adlerweb/iSysBus/misc/appnotes/README.txt

These files where removed from the original repository due to copyright concerns.

https://www.nxp.com/docs/en/application-note/AN96116.pdf
https://www.microchip.com/wwwAppNotes/AppNotes.aspx?appnote=en590906
https://www.microchip.com/wwwAppNotes/AppNotes.aspx?appnote=en591393
http://ww1.microchip.com/downloads/en/appnotes/doc2563.pdf
AVR055: Using a 32 kHz crystal to calibrate the internal RC oscillator
http://ww1.microchip.com/downloads/en/AppNotes/Atmel-2508-Zero-Cross-Detector_ApplicationNote_AVR182.pdf
https://www.microchip.com/wwwappnotes/appnotes.aspx?appnote=en591191
http://ww1.microchip.com/downloads/en/appnotes/atmel-2559-characterization-and-calibration-of-the-adc-on-an-avr_applicationnote_avr120.pdf
https://www.microchip.com/wwwAppNotes/AppNotes.aspx?appnote=en591540
http://ww1.microchip.com/downloads/en/AppNotes/Atmel-8108-Calibration-of-the-AVRs-Internal-Temperature-Reference_ApplicationNote_AVR122.pdf
AVR411
AVR415
AVR151
AVR303
AVR319
AVR320
AVR311
AVR315
AVR460
AVR461
Avr462
