adlerweb/iSysBus/misc/datasheets/mechanical/RJ45-Connector.pdf.txt

DELETED. Please search online for RJ45-Connector.pdf
