adlerweb/iSysBus/misc/datasheets/mechanical/USB-B-Connector.pdf.txt

DELETED. Please search online for USB-B-Connector.pdf
