adlerweb/iSysBus/misc/funk_steckdosen/radio_protocol.txt

   1011001011011011001011001001011001011011011001011011011001 Früher button 1 ein
1001011001011011011001011001001011001011011011001011011011001 gerade gescannt
01011101001011101110

1001011001011011011001011001001011001001011011001011011001001 Button 2 ein
--------------------------------------D-----------------D---- Differenz

1001011001011011011001011001001011001011001011001011011011011 Button 3 ein
-----------------------------------------D-----------------D- Diffenenz zu button 1
01011101001010101111

1001011001011011011001011001001011001001001011001011011001011 Button 4 ein
--------------------------------------D--D--------------D--D- 
01011101001000101101

1001011001011011011001011001001011001011011011011011011011    Button 1 AUs
1001011001011011011001011001001011001011011011011011011011011
-----------------------------------------------D--------D--D- Differnez zu button 1

1001011001011011011001011001001011001001011011011011011001011 Button 2 Aus
-----------------------------------------------D-----------D-

1001011001011011011001011001001011001011001011011011011011001 Button 3 Aus
-----------------------------------------------D-----------D-

1001011001011011011001011001001011001011001011011001011001001 Heller
--------------------------------------------------D-----D--D-

Anderer Code:
1001001001001001011011001001011001001011011011001011011011 (0)
1001001001001001011011001001011001001011011011001011011011001 Button 1 Neuer Code
-----D-----D--D-----D--D-----D--D---------------------------- Differenz zu Altem Button 1
--c--c--c--c--c--c--c--c--c--c--c--c--c--c--c--c--c--c--c--c-

Nochmal neuer Code
1011001001001001011011011001001001001011011011001011011011001 Button 1 Neuer Code
--D--D-----D--D-----D-----------D---------------------------- Differenz zu ganz altem code
10 00 01 11 00 00 11 10 11 10

1011001001001001011011011001001001001001001001001011011011011 Alle ein
--D--D-----D--D-----D-----------D-----D--D--D--------------D- Diff zu button1 Ein
10 00 01 11 00 00 00 00 11 11

1011001001001001011011011001001001001001001001001001011001011 Dimmen
--------------------------------------------------D-----D---- Diff zu alle ein

--c--c--c--c--c--c--c--c--c--c--c--c--c--c--c--c--c--c--c--c- c für variabel
10x10x10x10x10x10x10x10x10x10x10x10x10x10x10x10x10x10x10x10x1 Aufbau der Daten, x für Variables bit
                                      1  1		      Button 1
                                      0  1                    Button 2
                                      1  0                    Button 3  
                                      0  0                    Button 4
                                               1              Ausschalte ( Null einschalten)
---------------------------------  ?			      Fernbedienungs code
                                                        ?  ?  Kontroll bit??
                                                  ?  ?        Heller Dunkler ??
                                            0                 Alle 

bei 1450 Baud 
Tipp zum Auslesen: nur nach doppel 1 und doppel 0 suchen  11=1, doppel 00 = 0

Daten:
01 01 11 01 00 10 11 10 11 10 bu1
01 01 11 01 00 10 10 10 11 11 bu3
01 01 11 01 00 10 00 10 11 01 bu4
10 00 01 11 00 00 00 00 11 11 Alle ein andere code
10 00 01 11 00 00 11 10 11 10 button 1 neuer code

xor
01 00 11 10 10 00 11 01 10
01 00 11 10 10 00 10 00 11
01 00 11 10 10 00 00 00 11  ! passt noch net ?? Ausnahme
10 10 11 00 00 00 00 00 11
10 10 11 00 00 00 11 01 10
