adlerweb/iSysBus/misc/funk_steckdosen/protocol.jpg

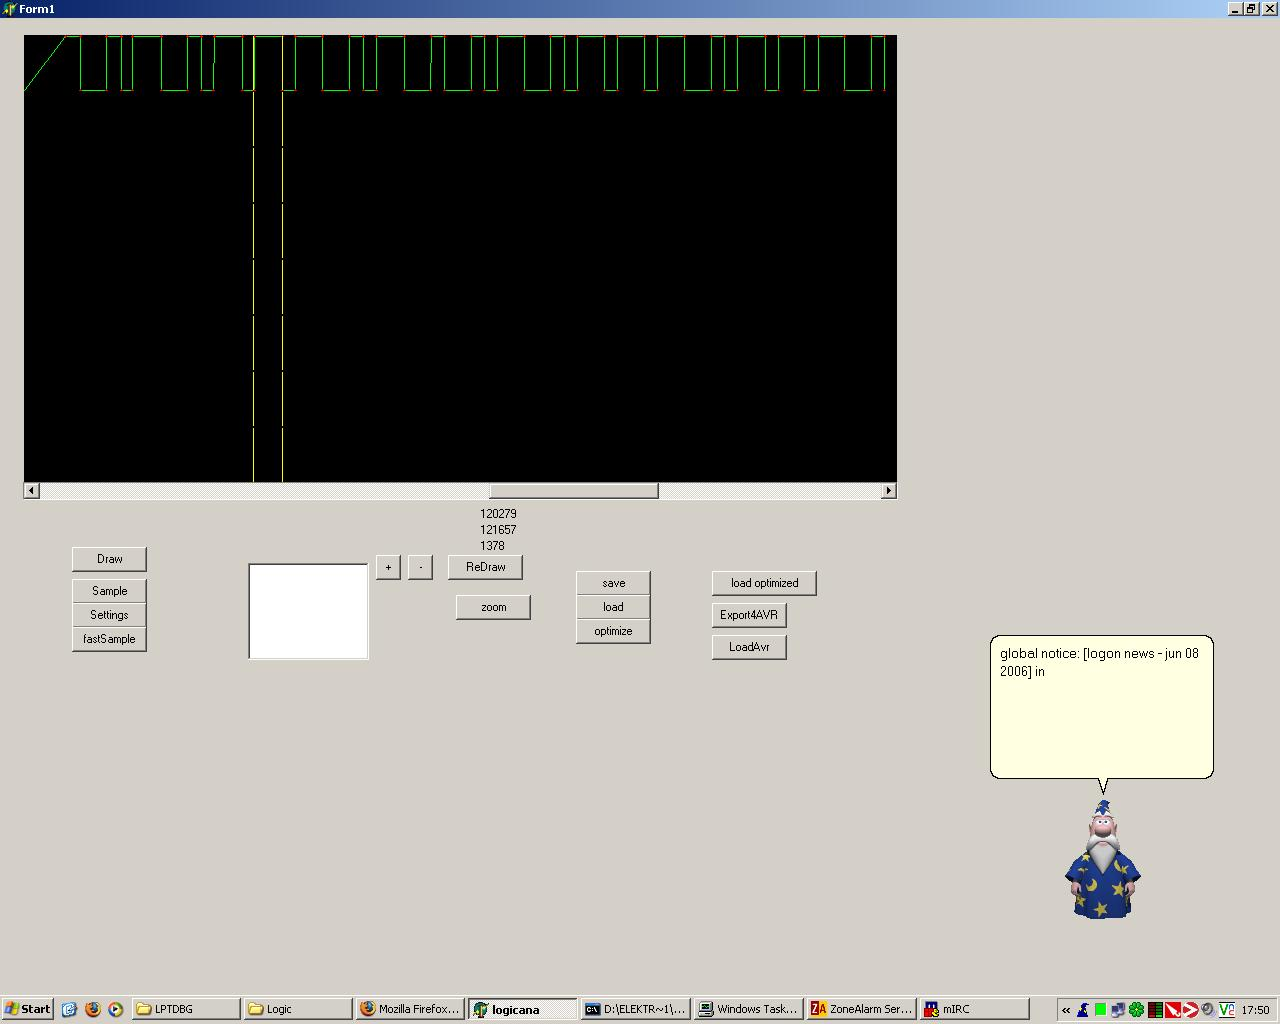
misc/funk_steckdosen/protocol.jpg
