adlerweb/iSysBus/software/sniffer/release/0.8.35/screenshot.png

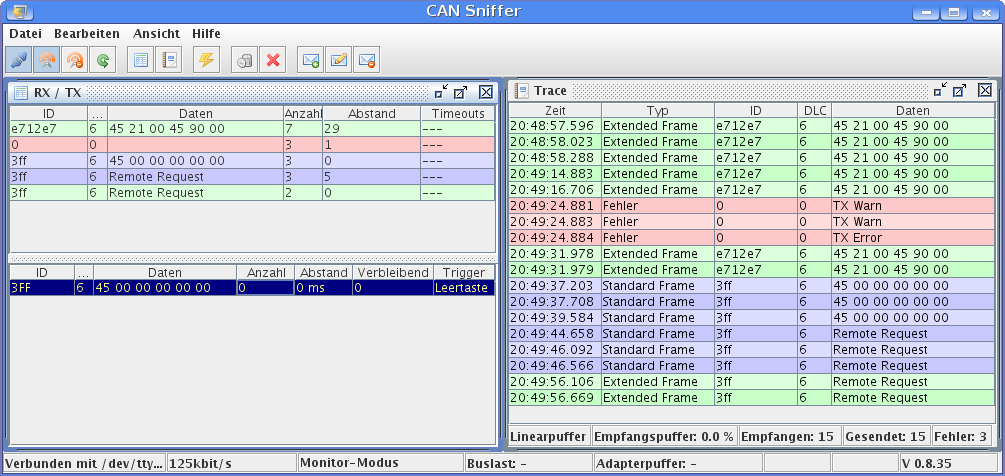
software/sniffer/release/0.8.35/screenshot.png
