adlerweb/iSysBus/misc/datasheets/supply/LM2574_StepDown-VoltageRegulator.pdf.txt

DELETED. Please search online for LM2574_StepDown-VoltageRegulator.pdf
