adlerweb/iSysBus/misc/datasheets/microcontrollers/AVR_Instruction_Set.pdf.txt

DELETED. Please search online for AVR_Instruction_Set.pdf
