adlerweb/iSysBus/misc/datasheets/misc/TS912_STM_Operational_Amplifier_2-fach.pdf.txt

DELETED. Please search online for TS912_STM_Operational_Amplifier_2-fach.pdf
