adlerweb/iSysBus/misc/docs/can_measured-timings/bits.ods

 |  |  |  |  |  |  |  |  |  |  |  |  | SOF | ID[10..0] |  |  |  |  |  |  |  |  |  |  | SRR | IDE | EID[17..0] |  |  |  |  |  |  |  |  |  |  |  |  |  |  |  |  |  | RTR | RB |  | DLC[3..0] |  |  |  | DATA0[7..0]
 |  |  |  |  |  |  |  |  |  |  |  |  |  | 10 | 9 | 8 | 7 | 6 | 5 | 4 | 3 | 2 | 1 | 0 |  |  | 17 | 16 | 15 | 14 | 13 | 12 | 11 | 10 | 9 | 8 | 7 | 6 | 5 | 4 | 3 | 2 | 1 | 0 |  | 1 | 0 | 3 | 2 | 1 | 0 | 7 | 6 | 5 | 4 | 3 | 2 | 1 | 0
 |  |  |  |  |  |  |  |  |  |  | d | d | d | d | d | r | r | r | d | d | d | d | d | r | r | r | d | r | r | r | r | d | r | r | r | r | r | d | r | r | r | d | d | r | d | d | d | d | d | r | d | r | d | d | r | r | r | d | r
0 | 0 | 0 | 0 | 0 | 0 | 0 | 0 | 0 | 0 | 0 | 0 | 0 | 0 | 0 | 0 | 1 | 1 | 1 | 0 | 0 | 0 | 0 | 0 | 1 | 1 | 1 | 0 | 1 | 1 | 1 | 1 | 0 | 1 | 1 | 1 | 1 | 1 | 0 | 1 | 1 | 1 | 0 | 0 | 1 | 0 | 0 | 0 | 0 | 0 | 1 | 0 | 1 | 0 | 0 | 1 | 1 | 1 | 0 | 1
 |  |  |  |  |  |  |  |  |  |  |  |  |  |  |  |  |  |  |  |  |  |  |  |  |  |  |  |  |  |  |  |  |  |  |  |  |  |  |  |  |  |  |  |  |  |  |  | 2 |  |  |  | 0x9D
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
