adlerweb/iSysBus/misc/docs/can_measured-timings/50kBaud_RS8k.tif

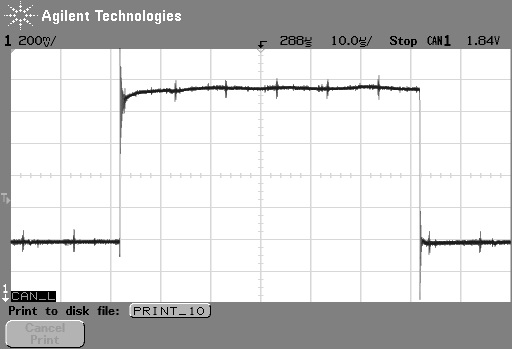
misc/docs/can_measured-timings/50kBaud_RS8k.tif
