adlerweb/iSysBus/misc/docs/can_measured-timings/50kBaud_RS47k.tif

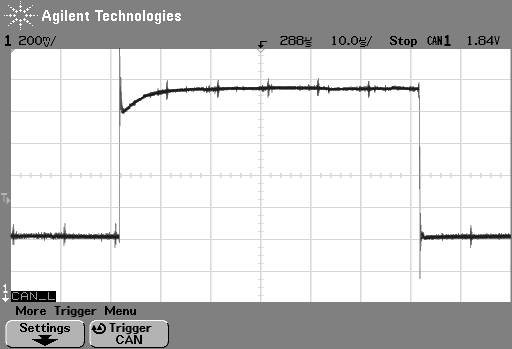
misc/docs/can_measured-timings/50kBaud_RS47k.tif
