adlerweb/iSysBus/misc/docs/can_measured-timings/50kBaud_RS47k_Varistor12nF.tif

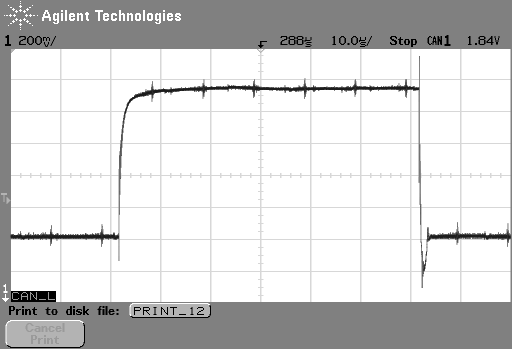
misc/docs/can_measured-timings/50kBaud_RS47k_Varistor12nF.tif
