adlerweb/iSysBus/misc/docs/can_measured-timings/125kBaud_RS47k_2.tif

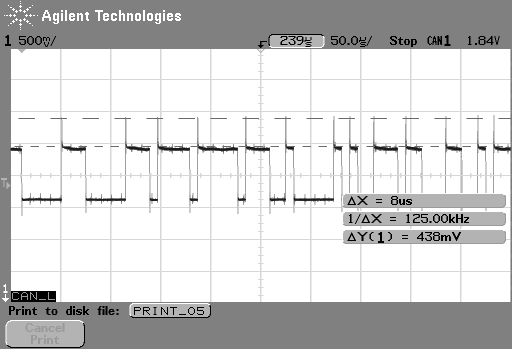
misc/docs/can_measured-timings/125kBaud_RS47k_2.tif
