adlerweb/iSysBus/misc/datasheets/interfacecontrollers/ENC28J60-Errata.pdf.txt

DELETED. Please search online for ENC28J60-Errata.pdf
