adlerweb/iSysBus/devices/circuit_boards/pcb_2_in_wall_input/trunk/pcb_2.brd

## EAGLE design devices/circuit_boards/pcb_2_in_wall_input/trunk/pcb_2.brd (2018-11-25)

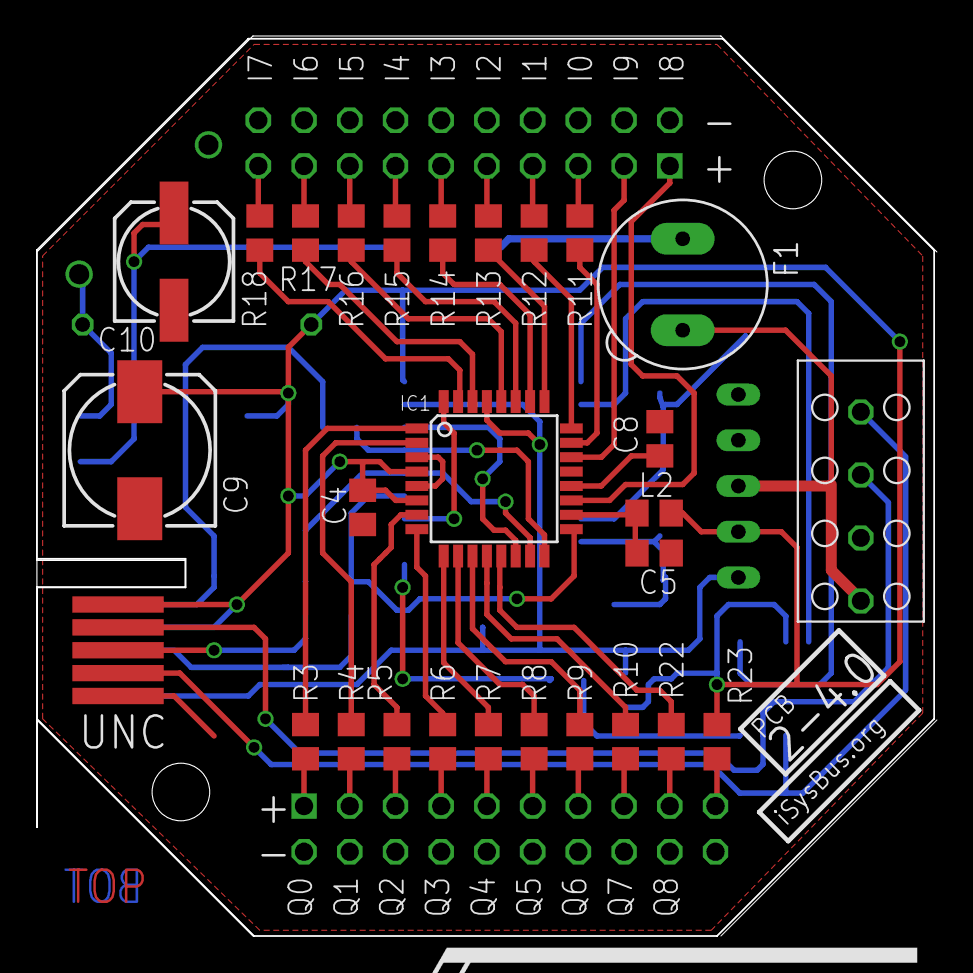
[picture p12: board pcb_2.brd from above]

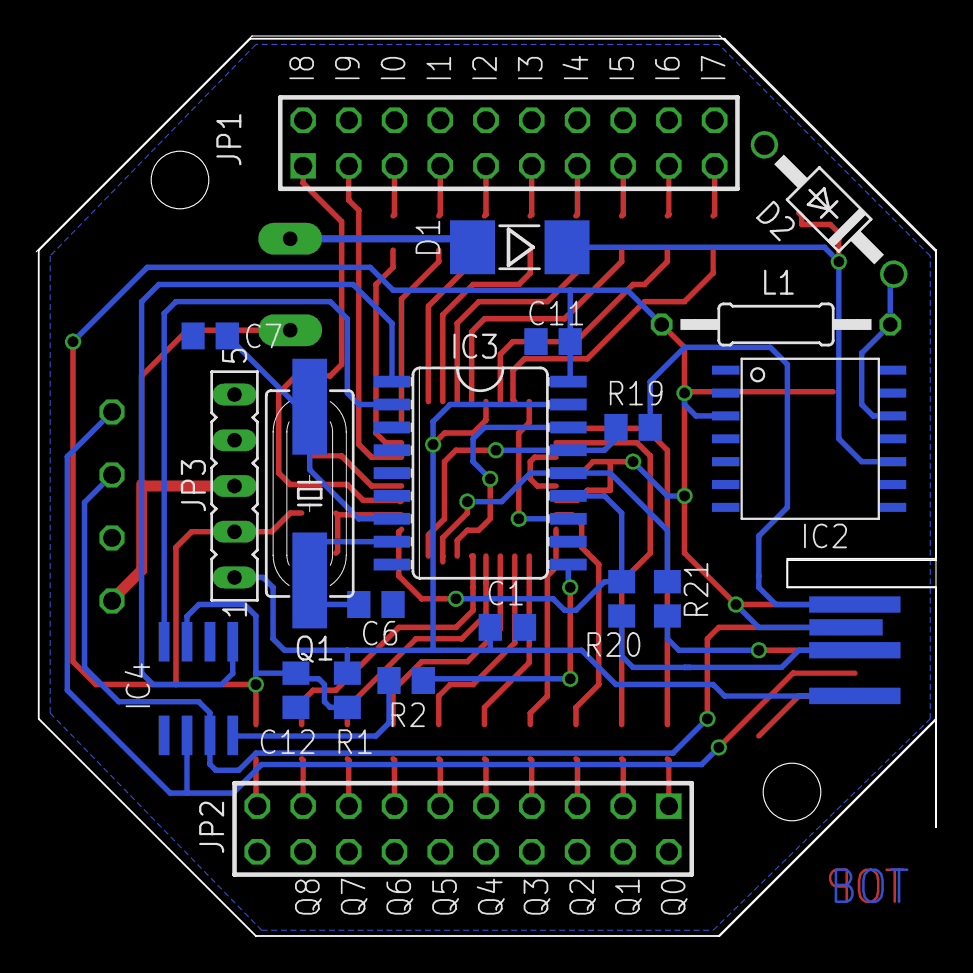
[picture p13: board pcb_2.brd from below]

Board: 2 copper layers, 49.8 x 49.8 mm, 54 parts (20 on the bottom side), 62 nets.

Parts:
C1, C4, C5, C8, C11, C12: 100n; C0805
C6, C7: 22p; C0805
C9: 330µ/16V; 153CLV-0810
C10: 22µ/35V; 153CLV-0605
D1: 1N4001SMD; MELF
D2: MUR110; DO41-10
F1: 315mA; 19560
IC1: ATMEGA168; TQFP32-08
IC2: LM257414WM; 14WM
IC3: MCP2515SO; SO18L
IC4: PCA82C250T; SO08
JP1: IN; 2X10
JP2: OUT; 2X10
JP3: SUP; FE05-1
L1: 470µ; 0207/12
L2: 10µ; L0805
Q1: 4M; HC49UP
R1: 10k; R0805
R2: 82k; R0805
R3, R4, R5, R6, R7, R8, R9, R10, R11, R12, R13, R14, R15, R16, R17, R18, R19, R20, R21, R22: 1k5; R0805
R23: 0R; R0805
U$1: ISYSBUS_LOGO
U$2: FIELD_ISB_PLACE
U$3: 2-4.0; FIELD_PCB_PLACE
UNC: UNC_ISP; UNC_PADS_ISP
UNC_CAN1: UNC_CAN; UNC_PADS_CAN
UNC_DP1: UNC_DP; UNC_PADS_DP
UNC_SUPPLY1: UNC_SUPPLY; UNC_PADS_SUPPLY
X1: iSysBus; PHOENIX_FK-MPT_4

Connections:
+24V: F1.2, JP3.3, X1.1
CAN_H: IC4.7, UNC_CAN1.B2, X1.3
CAN_L: IC4.6, UNC_CAN1.B4, X1.4
GND: C1.2, C4.2, C5.2, C6.2, C7.2, C8.2, C9.-, C10.-, C11.2, C12.2, D2.A, IC1.3, IC1.5, IC1.21, IC2.4, IC2.5, IC2.6, IC3.9, IC4.2, JP1.2, JP1.4, JP1.6, JP1.8, JP1.10, JP1.12, JP1.14, JP1.16, JP1.18, JP1.20, JP2.2, JP2.4, JP2.6, JP2.8, JP2.10, JP2.12, JP2.14, JP2.16, JP2.18, JP2.20, JP3.5, UNC_SUPPLY1.B5, X1.2
IN0: IC1.23, R11.1
IN1: IC1.24, R12.1
IN2: IC1.25, R13.1
IN3: IC1.26, R14.1
IN4: IC1.27, R15.1
IN5: IC1.28, R16.1
IN6: IC1.30, R17.1
IN7: IC1.31, R18.1
IN8: IC1.19, JP1.1
IN9: IC1.22, JP1.3
INT: IC1.32, IC3.12
MISO: IC1.16, IC3.15, R19.1
MOSI: IC1.15, IC3.14, R21.1
unnamed: D1.A, F1.1
unnamed: C5.1, IC1.18, L2.2
unnamed: D2.C, IC2.12, L1.2
unnamed: IC4.8, R2.2
unnamed: C6.1, IC3.8, Q1.1
unnamed: C8.1, IC1.20
unnamed: IC3.1, IC4.1
unnamed: IC3.2, IC4.4
unnamed: C7.1, IC3.7, Q1.2
unnamed: JP2.19, R23.2
unnamed: JP2.1, R3.2
unnamed: JP2.3, R4.2
unnamed: JP2.5, R5.2
unnamed: JP2.7, R6.2
unnamed: JP2.9, R7.2
unnamed: JP2.11, R8.2
unnamed: JP2.13, R9.2
unnamed: JP2.15, R10.2
unnamed: JP1.19, R18.2
unnamed: JP1.17, R17.2
unnamed: JP1.15, R16.2
unnamed: JP1.13, R15.2
unnamed: JP1.11, R14.2
unnamed: JP1.9, R13.2
unnamed: JP1.7, R12.2
unnamed: JP1.5, R11.2
unnamed: R20.2, UNC.A3
unnamed: R19.2, UNC.A1
unnamed: R21.2, UNC.B3
unnamed: JP2.17, R22.2
OUT0: IC1.1, R3.1
OUT1: IC1.2, R4.1
OUT2: IC1.7, R5.1
OUT3: IC1.8, R6.1
OUT4: IC1.9, R7.1
OUT5: IC1.10, R8.1
OUT6: IC1.11, R9.1
OUT7: IC1.12, R10.1
OUT8: IC1.13, R22.1
RESET: C1.1, IC1.29, IC3.17, JP3.1, R1.1, UNC.A5
RS: IC3.10, R2.1
SCK: IC1.17, IC3.13, R20.1
SS: IC1.14, IC3.16
V+: C10.+, D1.C, IC2.10
VCC: C4.1, C9.+, C11.1, C12.1, IC1.4, IC1.6, IC2.3, IC3.18, IC4.3, JP3.2, L1.1, L2.1, R1.2, R23.1, UNC_DP1.A2, UNC_SUPPLY1.B1
