adlerweb/iSysBus/firmware/fw/fw_27/trunk/main.c

/**
 * @file		fw/fw_27/trunk/main.c
 *
 * @brief		Firmware.
 *
 * This file includes the Firmware.
 *
 * @author		© Patrick Amrhein <trick-at-isysbus-dot-org> 01.05.2010.
 *
 * @date		$Date$
 *
 * @version		$Rev$
 *
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
 * You should have received a copy of the GNU General Public License
 * along with this program. If not, see http:*www.gnu.org/licenses.
 */





#include <stdio.h>



#define USE_AVRLIB_ISB



#include <trunk/core/isb_fw_app.h>



const uint8_t Isb_Firmware_Code[4] = { 0x1B, 0x00, 0x00, 0x00 };



#define ISB_INF_CAN0 TRUE
#if ISB_INF_CAN0 == TRUE
	#define ISB_INF_CAN0_CLOCK 8000000
	#define ISB_INF_CAN0_SPEED 50000
	#define ISB_INF_CAN0_SS PORTB_PIN4
	#define ISB_INF_CAN0_RS NONE
	#define ISB_INF_CAN0_INT INTERRUPT1
	#define ISB_INF_CAN0_MODE LIB_MCP2515_MODE_NORMAL
#endif /* ISB_INF_CAN0 == TRUE */



#define ISB_CH_MAX 8

#define ISB_CH_0 0
#if defined(ISB_CH_0)
	#define ISB_CH_0_EEADDR_CTRL 0x0000
	#define ISB_APP_DIGOUT_0 0
	#define ISB_APP_DIGOUT_0_CH 0
	#define ISB_APP_DIGOUT_0_PIN0 B | 0
	#define ISB_APP_DIGOUT_0_PIN1 A | 0 | PULLUP
	#define ISB_APP_DIGOUT_0_EEADDR_CFG0 0x0001
	#define ISB_APP_DIGOUT_0_OBJ_0_EEADDR_CTRL 0x0002
	#define ISB_APP_DIGOUT_0_OBJ_0_EEADDR_TOV 0x0003
	#define ISB_APP_DIGOUT_0_OBJ_0_EEADDR_INITVALUE 0x0004
	#define ISB_APP_DIGOUT_0_OBJ_0 0
	#define ISB_OBJ_0 0
	#define ISB_OBJ_0_CH 0
	#define ISB_APP_DIGOUT_0_EEADDR_CFG1 0x0009
	#define ISB_APP_DIGOUT_0_OBJ_1_EEADDR_CTRL 0x000A
	#define ISB_APP_DIGOUT_0_OBJ_1_EEADDR_TOV 0x000B
	#define ISB_APP_DIGOUT_0_OBJ_1_EEADDR_INITVALUE 0x000C
	#define ISB_APP_DIGOUT_0_OBJ_1 1
	#define ISB_OBJ_1 1
	#define ISB_OBJ_1_CH 0
	#define ISB_APP_DIGOUT_0_EEADDR_CFG2 0x0011
	#define ISB_APP_DIGOUT_0_OBJ_2_EEADDR_CTRL 0x0012
	#define ISB_APP_DIGOUT_0_OBJ_2_EEADDR_TOV 0x0013
	#define ISB_APP_DIGOUT_0_OBJ_2_EEADDR_INITVALUE 0x0014
	#define ISB_APP_DIGOUT_0_OBJ_2 2
	#define ISB_OBJ_2 2
	#define ISB_OBJ_2_CH 0
	#define ISB_APP_DIGOUT_0_EEADDR_CFG3 0x0019
	#define ISB_APP_DIGOUT_0_EEADDR_CFG4 0x001A
	#define ISB_APP_DIGOUT_0_EEADDR_CFG5 0x001B
	#define ISB_APP_DIGOUT_0_EEADDR_CFG6 0x001C
	#define ISB_APP_DIGOUT_0_EEADDR_CFG7 0x001D
	#define ISB_APP_DIGOUT_0_EEADDR_CFG8 0x001E
	#define ISB_APP_DIGOUT_0_EEADDR_CFG9 0x001F
	#define ISB_APP_DIGOUT_0_EEADDR_CFG10 0x0020
	#define ISB_APP_DIGOUT_0_OBJ_3_EEADDR_CTRL 0x0021
	#define ISB_APP_DIGOUT_0_OBJ_3_EEADDR_TOV 0x0022
	#define ISB_APP_DIGOUT_0_OBJ_3_EEADDR_INITVALUE 0x0023
	#define ISB_APP_DIGOUT_0_OBJ_3 3
	#define ISB_OBJ_3 3
	#define ISB_OBJ_3_CH 0
	#define ISB_CH_0_EEADDR_CRC 0x0028
#endif /* ISB_CH_0 */

#define ISB_CH_1 1
#if defined(ISB_CH_1)
	#define ISB_CH_1_EEADDR_CTRL 0x0029
	#define ISB_APP_DIGOUT_1 1
	#define ISB_APP_DIGOUT_1_CH 1
	#define ISB_APP_DIGOUT_1_PIN0 B | 1
	#define ISB_APP_DIGOUT_1_PIN1 A | 1 | PULLUP
	#define ISB_APP_DIGOUT_1_EEADDR_CFG0 0x002A
	#define ISB_APP_DIGOUT_1_OBJ_0_EEADDR_CTRL 0x002B
	#define ISB_APP_DIGOUT_1_OBJ_0_EEADDR_TOV 0x002C
	#define ISB_APP_DIGOUT_1_OBJ_0_EEADDR_INITVALUE 0x002D
	#define ISB_APP_DIGOUT_1_OBJ_0 4
	#define ISB_OBJ_4 4
	#define ISB_OBJ_4_CH 1
	#define ISB_APP_DIGOUT_1_EEADDR_CFG1 0x0032
	#define ISB_APP_DIGOUT_1_OBJ_1_EEADDR_CTRL 0x0033
	#define ISB_APP_DIGOUT_1_OBJ_1_EEADDR_TOV 0x0034
	#define ISB_APP_DIGOUT_1_OBJ_1_EEADDR_INITVALUE 0x0035
	#define ISB_APP_DIGOUT_1_OBJ_1 5
	#define ISB_OBJ_5 5
	#define ISB_OBJ_5_CH 1
	#define ISB_APP_DIGOUT_1_EEADDR_CFG2 0x003A
	#define ISB_APP_DIGOUT_1_OBJ_2_EEADDR_CTRL 0x003B
	#define ISB_APP_DIGOUT_1_OBJ_2_EEADDR_TOV 0x003C
	#define ISB_APP_DIGOUT_1_OBJ_2_EEADDR_INITVALUE 0x003D
	#define ISB_APP_DIGOUT_1_OBJ_2 6
	#define ISB_OBJ_6 6
	#define ISB_OBJ_6_CH 1
	#define ISB_APP_DIGOUT_1_EEADDR_CFG3 0x0042
	#define ISB_APP_DIGOUT_1_EEADDR_CFG4 0x0043
	#define ISB_APP_DIGOUT_1_EEADDR_CFG5 0x0044
	#define ISB_APP_DIGOUT_1_EEADDR_CFG6 0x0045
	#define ISB_APP_DIGOUT_1_EEADDR_CFG7 0x0046
	#define ISB_APP_DIGOUT_1_EEADDR_CFG8 0x0047
	#define ISB_APP_DIGOUT_1_EEADDR_CFG9 0x0048
	#define ISB_APP_DIGOUT_1_EEADDR_CFG10 0x0049
	#define ISB_APP_DIGOUT_1_OBJ_3_EEADDR_CTRL 0x004A
	#define ISB_APP_DIGOUT_1_OBJ_3_EEADDR_TOV 0x004B
	#define ISB_APP_DIGOUT_1_OBJ_3_EEADDR_INITVALUE 0x004C
	#define ISB_APP_DIGOUT_1_OBJ_3 7
	#define ISB_OBJ_7 7
	#define ISB_OBJ_7_CH 1
	#define ISB_CH_1_EEADDR_CRC 0x0051
#endif /* ISB_CH_1 */

#define ISB_CH_2 2
#if defined(ISB_CH_2)
	#define ISB_CH_2_EEADDR_CTRL 0x0052
	#define ISB_APP_DIGOUT_2 2
	#define ISB_APP_DIGOUT_2_CH 2
	#define ISB_APP_DIGOUT_2_PIN0 C | 2
	#define ISB_APP_DIGOUT_2_PIN1 A | 2 | PULLUP
	#define ISB_APP_DIGOUT_2_EEADDR_CFG0 0x0053
	#define ISB_APP_DIGOUT_2_OBJ_0_EEADDR_CTRL 0x0054
	#define ISB_APP_DIGOUT_2_OBJ_0_EEADDR_TOV 0x0055
	#define ISB_APP_DIGOUT_2_OBJ_0_EEADDR_INITVALUE 0x0056
	#define ISB_APP_DIGOUT_2_OBJ_0 8
	#define ISB_OBJ_8 8
	#define ISB_OBJ_8_CH 2
	#define ISB_APP_DIGOUT_2_EEADDR_CFG1 0x005B
	#define ISB_APP_DIGOUT_2_OBJ_1_EEADDR_CTRL 0x005C
	#define ISB_APP_DIGOUT_2_OBJ_1_EEADDR_TOV 0x005D
	#define ISB_APP_DIGOUT_2_OBJ_1_EEADDR_INITVALUE 0x005E
	#define ISB_APP_DIGOUT_2_OBJ_1 9
	#define ISB_OBJ_9 9
	#define ISB_OBJ_9_CH 2
	#define ISB_APP_DIGOUT_2_EEADDR_CFG2 0x0063
	#define ISB_APP_DIGOUT_2_OBJ_2_EEADDR_CTRL 0x0064
	#define ISB_APP_DIGOUT_2_OBJ_2_EEADDR_TOV 0x0065
	#define ISB_APP_DIGOUT_2_OBJ_2_EEADDR_INITVALUE 0x0066
	#define ISB_APP_DIGOUT_2_OBJ_2 10
	#define ISB_OBJ_10 10
	#define ISB_OBJ_10_CH 2
	#define ISB_APP_DIGOUT_2_EEADDR_CFG3 0x006B
	#define ISB_APP_DIGOUT_2_EEADDR_CFG4 0x006C
	#define ISB_APP_DIGOUT_2_EEADDR_CFG5 0x006D
	#define ISB_APP_DIGOUT_2_EEADDR_CFG6 0x006E
	#define ISB_APP_DIGOUT_2_EEADDR_CFG7 0x006F
	#define ISB_APP_DIGOUT_2_EEADDR_CFG8 0x0070
	#define ISB_APP_DIGOUT_2_EEADDR_CFG9 0x0071
	#define ISB_APP_DIGOUT_2_EEADDR_CFG10 0x0072
	#define ISB_APP_DIGOUT_2_OBJ_3_EEADDR_CTRL 0x0073
	#define ISB_APP_DIGOUT_2_OBJ_3_EEADDR_TOV 0x0074
	#define ISB_APP_DIGOUT_2_OBJ_3_EEADDR_INITVALUE 0x0075
	#define ISB_APP_DIGOUT_2_OBJ_3 11
	#define ISB_OBJ_11 11
	#define ISB_OBJ_11_CH 2
	#define ISB_CH_2_EEADDR_CRC 0x007A
#endif /* ISB_CH_2 */

#define ISB_CH_3 3
#if defined(ISB_CH_3)
	#define ISB_CH_3_EEADDR_CTRL 0x007B
	#define ISB_APP_DIGOUT_3 3
	#define ISB_APP_DIGOUT_3_CH 3
	#define ISB_APP_DIGOUT_3_PIN0 C | 3
	#define ISB_APP_DIGOUT_3_PIN1 A | 3 | PULLUP
	#define ISB_APP_DIGOUT_3_EEADDR_CFG0 0x007C
	#define ISB_APP_DIGOUT_3_OBJ_0_EEADDR_CTRL 0x007D
	#define ISB_APP_DIGOUT_3_OBJ_0_EEADDR_TOV 0x007E
	#define ISB_APP_DIGOUT_3_OBJ_0_EEADDR_INITVALUE 0x007F
	#define ISB_APP_DIGOUT_3_OBJ_0 12
	#define ISB_OBJ_12 12
	#define ISB_OBJ_12_CH 3
	#define ISB_APP_DIGOUT_3_EEADDR_CFG1 0x0084
	#define ISB_APP_DIGOUT_3_OBJ_1_EEADDR_CTRL 0x0085
	#define ISB_APP_DIGOUT_3_OBJ_1_EEADDR_TOV 0x0086
	#define ISB_APP_DIGOUT_3_OBJ_1_EEADDR_INITVALUE 0x0087
	#define ISB_APP_DIGOUT_3_OBJ_1 13
	#define ISB_OBJ_13 13
	#define ISB_OBJ_13_CH 3
	#define ISB_APP_DIGOUT_3_EEADDR_CFG2 0x008C
	#define ISB_APP_DIGOUT_3_OBJ_2_EEADDR_CTRL 0x008D
	#define ISB_APP_DIGOUT_3_OBJ_2_EEADDR_TOV 0x008E
	#define ISB_APP_DIGOUT_3_OBJ_2_EEADDR_INITVALUE 0x008F
	#define ISB_APP_DIGOUT_3_OBJ_2 14
	#define ISB_OBJ_14 14
	#define ISB_OBJ_14_CH 3
	#define ISB_APP_DIGOUT_3_EEADDR_CFG3 0x0094
	#define ISB_APP_DIGOUT_3_EEADDR_CFG4 0x0095
	#define ISB_APP_DIGOUT_3_EEADDR_CFG5 0x0096
	#define ISB_APP_DIGOUT_3_EEADDR_CFG6 0x0097
	#define ISB_APP_DIGOUT_3_EEADDR_CFG7 0x0098
	#define ISB_APP_DIGOUT_3_EEADDR_CFG8 0x0099
	#define ISB_APP_DIGOUT_3_EEADDR_CFG9 0x009A
	#define ISB_APP_DIGOUT_3_EEADDR_CFG10 0x009B
	#define ISB_APP_DIGOUT_3_OBJ_3_EEADDR_CTRL 0x009C
	#define ISB_APP_DIGOUT_3_OBJ_3_EEADDR_TOV 0x009D
	#define ISB_APP_DIGOUT_3_OBJ_3_EEADDR_INITVALUE 0x009E
	#define ISB_APP_DIGOUT_3_OBJ_3 15
	#define ISB_OBJ_15 15
	#define ISB_OBJ_15_CH 3
	#define ISB_CH_3_EEADDR_CRC 0x00A3
#endif /* ISB_CH_3 */

#define ISB_CH_4 4
#if defined(ISB_CH_4)
	#define ISB_CH_4_EEADDR_CTRL 0x00A4
	#define ISB_APP_DIGOUT_4 4
	#define ISB_APP_DIGOUT_4_CH 4
	#define ISB_APP_DIGOUT_4_PIN0 C | 4
	#define ISB_APP_DIGOUT_4_PIN1 A | 4 | PULLUP
	#define ISB_APP_DIGOUT_4_EEADDR_CFG0 0x00A5
	#define ISB_APP_DIGOUT_4_OBJ_0_EEADDR_CTRL 0x00A6
	#define ISB_APP_DIGOUT_4_OBJ_0_EEADDR_TOV 0x00A7
	#define ISB_APP_DIGOUT_4_OBJ_0_EEADDR_INITVALUE 0x00A8
	#define ISB_APP_DIGOUT_4_OBJ_0 16
	#define ISB_OBJ_16 16
	#define ISB_OBJ_16_CH 4
	#define ISB_APP_DIGOUT_4_EEADDR_CFG1 0x00AD
	#define ISB_APP_DIGOUT_4_OBJ_1_EEADDR_CTRL 0x00AE
	#define ISB_APP_DIGOUT_4_OBJ_1_EEADDR_TOV 0x00AF
	#define ISB_APP_DIGOUT_4_OBJ_1_EEADDR_INITVALUE 0x00B0
	#define ISB_APP_DIGOUT_4_OBJ_1 17
	#define ISB_OBJ_17 17
	#define ISB_OBJ_17_CH 4
	#define ISB_APP_DIGOUT_4_EEADDR_CFG2 0x00B5
	#define ISB_APP_DIGOUT_4_OBJ_2_EEADDR_CTRL 0x00B6
	#define ISB_APP_DIGOUT_4_OBJ_2_EEADDR_TOV 0x00B7
	#define ISB_APP_DIGOUT_4_OBJ_2_EEADDR_INITVALUE 0x00B8
	#define ISB_APP_DIGOUT_4_OBJ_2 18
	#define ISB_OBJ_18 18
	#define ISB_OBJ_18_CH 4
	#define ISB_APP_DIGOUT_4_EEADDR_CFG3 0x00BD
	#define ISB_APP_DIGOUT_4_EEADDR_CFG4 0x00BE
	#define ISB_APP_DIGOUT_4_EEADDR_CFG5 0x00BF
	#define ISB_APP_DIGOUT_4_EEADDR_CFG6 0x00C0
	#define ISB_APP_DIGOUT_4_EEADDR_CFG7 0x00C1
	#define ISB_APP_DIGOUT_4_EEADDR_CFG8 0x00C2
	#define ISB_APP_DIGOUT_4_EEADDR_CFG9 0x00C3
	#define ISB_APP_DIGOUT_4_EEADDR_CFG10 0x00C4
	#define ISB_APP_DIGOUT_4_OBJ_3_EEADDR_CTRL 0x00C5
	#define ISB_APP_DIGOUT_4_OBJ_3_EEADDR_TOV 0x00C6
	#define ISB_APP_DIGOUT_4_OBJ_3_EEADDR_INITVALUE 0x00C7
	#define ISB_APP_DIGOUT_4_OBJ_3 19
	#define ISB_OBJ_19 19
	#define ISB_OBJ_19_CH 4
	#define ISB_CH_4_EEADDR_CRC 0x00CC
#endif /* ISB_CH_4 */

#define ISB_CH_5 5
#if defined(ISB_CH_5)
	#define ISB_CH_5_EEADDR_CTRL 0x00CD
	#define ISB_APP_DIGOUT_5 5
	#define ISB_APP_DIGOUT_5_CH 5
	#define ISB_APP_DIGOUT_5_PIN0 C | 5
	#define ISB_APP_DIGOUT_5_PIN1 A | 5 | PULLUP
	#define ISB_APP_DIGOUT_5_EEADDR_CFG0 0x00CE
	#define ISB_APP_DIGOUT_5_OBJ_0_EEADDR_CTRL 0x00CF
	#define ISB_APP_DIGOUT_5_OBJ_0_EEADDR_TOV 0x00D0
	#define ISB_APP_DIGOUT_5_OBJ_0_EEADDR_INITVALUE 0x00D1
	#define ISB_APP_DIGOUT_5_OBJ_0 20
	#define ISB_OBJ_20 20
	#define ISB_OBJ_20_CH 5
	#define ISB_APP_DIGOUT_5_EEADDR_CFG1 0x00D6
	#define ISB_APP_DIGOUT_5_OBJ_1_EEADDR_CTRL 0x00D7
	#define ISB_APP_DIGOUT_5_OBJ_1_EEADDR_TOV 0x00D8
	#define ISB_APP_DIGOUT_5_OBJ_1_EEADDR_INITVALUE 0x00D9
	#define ISB_APP_DIGOUT_5_OBJ_1 21
	#define ISB_OBJ_21 21
	#define ISB_OBJ_21_CH 5
	#define ISB_APP_DIGOUT_5_EEADDR_CFG2 0x00DE
	#define ISB_APP_DIGOUT_5_OBJ_2_EEADDR_CTRL 0x00DF
	#define ISB_APP_DIGOUT_5_OBJ_2_EEADDR_TOV 0x00E0
	#define ISB_APP_DIGOUT_5_OBJ_2_EEADDR_INITVALUE 0x00E1
	#define ISB_APP_DIGOUT_5_OBJ_2 22
	#define ISB_OBJ_22 22
	#define ISB_OBJ_22_CH 5
	#define ISB_APP_DIGOUT_5_EEADDR_CFG3 0x00E6
	#define ISB_APP_DIGOUT_5_EEADDR_CFG4 0x00E7
	#define ISB_APP_DIGOUT_5_EEADDR_CFG5 0x00E8
	#define ISB_APP_DIGOUT_5_EEADDR_CFG6 0x00E9
	#define ISB_APP_DIGOUT_5_EEADDR_CFG7 0x00EA
	#define ISB_APP_DIGOUT_5_EEADDR_CFG8 0x00EB
	#define ISB_APP_DIGOUT_5_EEADDR_CFG9 0x00EC
	#define ISB_APP_DIGOUT_5_EEADDR_CFG10 0x00ED
	#define ISB_APP_DIGOUT_5_OBJ_3_EEADDR_CTRL 0x00EE
	#define ISB_APP_DIGOUT_5_OBJ_3_EEADDR_TOV 0x00EF
	#define ISB_APP_DIGOUT_5_OBJ_3_EEADDR_INITVALUE 0x00F0
	#define ISB_APP_DIGOUT_5_OBJ_3 23
	#define ISB_OBJ_23 23
	#define ISB_OBJ_23_CH 5
	#define ISB_CH_5_EEADDR_CRC 0x00F5
#endif /* ISB_CH_5 */

#define ISB_CH_6 6
#if defined(ISB_CH_6)
	#define ISB_CH_6_EEADDR_CTRL 0x00F6
	#define ISB_APP_DIGOUT_6 6
	#define ISB_APP_DIGOUT_6_CH 6
	#define ISB_APP_DIGOUT_6_PIN0 C | 6
	#define ISB_APP_DIGOUT_6_PIN1 A | 6 | PULLUP
	#define ISB_APP_DIGOUT_6_EEADDR_CFG0 0x00F7
	#define ISB_APP_DIGOUT_6_OBJ_0_EEADDR_CTRL 0x00F8
	#define ISB_APP_DIGOUT_6_OBJ_0_EEADDR_TOV 0x00F9
	#define ISB_APP_DIGOUT_6_OBJ_0_EEADDR_INITVALUE 0x00FA
	#define ISB_APP_DIGOUT_6_OBJ_0 24
	#define ISB_OBJ_24 24
	#define ISB_OBJ_24_CH 6
	#define ISB_APP_DIGOUT_6_EEADDR_CFG1 0x00FF
	#define ISB_APP_DIGOUT_6_OBJ_1_EEADDR_CTRL 0x0100
	#define ISB_APP_DIGOUT_6_OBJ_1_EEADDR_TOV 0x0101
	#define ISB_APP_DIGOUT_6_OBJ_1_EEADDR_INITVALUE 0x0102
	#define ISB_APP_DIGOUT_6_OBJ_1 25
	#define ISB_OBJ_25 25
	#define ISB_OBJ_25_CH 6
	#define ISB_APP_DIGOUT_6_EEADDR_CFG2 0x0107
	#define ISB_APP_DIGOUT_6_OBJ_2_EEADDR_CTRL 0x0108
	#define ISB_APP_DIGOUT_6_OBJ_2_EEADDR_TOV 0x0109
	#define ISB_APP_DIGOUT_6_OBJ_2_EEADDR_INITVALUE 0x010A
	#define ISB_APP_DIGOUT_6_OBJ_2 26
	#define ISB_OBJ_26 26
	#define ISB_OBJ_26_CH 6
	#define ISB_APP_DIGOUT_6_EEADDR_CFG3 0x010F
	#define ISB_APP_DIGOUT_6_EEADDR_CFG4 0x0110
	#define ISB_APP_DIGOUT_6_EEADDR_CFG5 0x0111
	#define ISB_APP_DIGOUT_6_EEADDR_CFG6 0x0112
	#define ISB_APP_DIGOUT_6_EEADDR_CFG7 0x0113
	#define ISB_APP_DIGOUT_6_EEADDR_CFG8 0x0114
	#define ISB_APP_DIGOUT_6_EEADDR_CFG9 0x0115
	#define ISB_APP_DIGOUT_6_EEADDR_CFG10 0x0116
	#define ISB_APP_DIGOUT_6_OBJ_3_EEADDR_CTRL 0x0117
	#define ISB_APP_DIGOUT_6_OBJ_3_EEADDR_TOV 0x0118
	#define ISB_APP_DIGOUT_6_OBJ_3_EEADDR_INITVALUE 0x0119
	#define ISB_APP_DIGOUT_6_OBJ_3 27
	#define ISB_OBJ_27 27
	#define ISB_OBJ_27_CH 6
	#define ISB_CH_6_EEADDR_CRC 0x011E
#endif /* ISB_CH_6 */

#define ISB_CH_7 7
#if defined(ISB_CH_7)
	#define ISB_CH_7_EEADDR_CTRL 0x011F
	#define ISB_APP_DIGOUT_7 7
	#define ISB_APP_DIGOUT_7_CH 7
	#define ISB_APP_DIGOUT_7_PIN0 C | 7
	#define ISB_APP_DIGOUT_7_PIN1 A | 7 | PULLUP
	#define ISB_APP_DIGOUT_7_EEADDR_CFG0 0x0120
	#define ISB_APP_DIGOUT_7_OBJ_0_EEADDR_CTRL 0x0121
	#define ISB_APP_DIGOUT_7_OBJ_0_EEADDR_TOV 0x0122
	#define ISB_APP_DIGOUT_7_OBJ_0_EEADDR_INITVALUE 0x0123
	#define ISB_APP_DIGOUT_7_OBJ_0 28
	#define ISB_OBJ_28 28
	#define ISB_OBJ_28_CH 7
	#define ISB_APP_DIGOUT_7_EEADDR_CFG1 0x0128
	#define ISB_APP_DIGOUT_7_OBJ_1_EEADDR_CTRL 0x0129
	#define ISB_APP_DIGOUT_7_OBJ_1_EEADDR_TOV 0x012A
	#define ISB_APP_DIGOUT_7_OBJ_1_EEADDR_INITVALUE 0x012B
	#define ISB_APP_DIGOUT_7_OBJ_1 29
	#define ISB_OBJ_29 29
	#define ISB_OBJ_29_CH 7
	#define ISB_APP_DIGOUT_7_EEADDR_CFG2 0x0130
	#define ISB_APP_DIGOUT_7_OBJ_2_EEADDR_CTRL 0x0131
	#define ISB_APP_DIGOUT_7_OBJ_2_EEADDR_TOV 0x0132
	#define ISB_APP_DIGOUT_7_OBJ_2_EEADDR_INITVALUE 0x0133
	#define ISB_APP_DIGOUT_7_OBJ_2 30
	#define ISB_OBJ_30 30
	#define ISB_OBJ_30_CH 7
	#define ISB_APP_DIGOUT_7_EEADDR_CFG3 0x0138
	#define ISB_APP_DIGOUT_7_EEADDR_CFG4 0x0139
	#define ISB_APP_DIGOUT_7_EEADDR_CFG5 0x013A
	#define ISB_APP_DIGOUT_7_EEADDR_CFG6 0x013B
	#define ISB_APP_DIGOUT_7_EEADDR_CFG7 0x013C
	#define ISB_APP_DIGOUT_7_EEADDR_CFG8 0x013D
	#define ISB_APP_DIGOUT_7_EEADDR_CFG9 0x013E
	#define ISB_APP_DIGOUT_7_EEADDR_CFG10 0x013F
	#define ISB_APP_DIGOUT_7_OBJ_3_EEADDR_CTRL 0x0140
	#define ISB_APP_DIGOUT_7_OBJ_3_EEADDR_TOV 0x0141
	#define ISB_APP_DIGOUT_7_OBJ_3_EEADDR_INITVALUE 0x0142
	#define ISB_APP_DIGOUT_7_OBJ_3 31
	#define ISB_OBJ_31 31
	#define ISB_OBJ_31_CH 7
	#define ISB_CH_7_EEADDR_CRC 0x0147
#endif /* ISB_CH_7 */



#define ISB_APP_DIGOUT_MAX 8
#define ISB_APP_DIGOUT_EXECTIME 10
#define ISB_APP_DIGOUT_DESTINATION_FEATURE_RELAIS TRUE
#define ISB_APP_DIGOUT_DESTINATION_FEATURE_SSR TRUE
#define ISB_APP_DIGOUT_DESTINATION_FEATURE_SLAVE_USART0 FALSE
#define ISB_APP_DIGOUT_DESTINATION_FEATURE_SLAVE_USART1 FALSE
#define ISB_APP_DIGOUT_FEATURE_LOGICFUNCTION TRUE
#define ISB_APP_DIGOUT_FEATURE_LOGICFUNCTION_AND TRUE
#define ISB_APP_DIGOUT_FEATURE_LOGICFUNCTION_OR TRUE
#define ISB_APP_DIGOUT_FEATURE_TIMEFUNCTION TRUE
#define ISB_APP_DIGOUT_FEATURE_TIMEFUNCTION_POWERUPDELAY TRUE
#define ISB_APP_DIGOUT_FEATURE_TIMEFUNCTION_POWERDOWNDELAY TRUE
#define ISB_APP_DIGOUT_FEATURE_TIMEFUNCTION_STAIRCASEFUNCTION TRUE
#define ISB_APP_DIGOUT_FEATURE_SPECIALFUNCTION TRUE
#define ISB_APP_DIGOUT_FEATURE_SPECIALFUNCTION_BLOCKING TRUE
#define ISB_APP_DIGOUT_FEATURE_SPECIALFUNCTION_BONDAGE TRUE
#define ISB_APP_DIGOUT_FEATURE_RESULT TRUE

#define ISB_OBJ_MAX 32
#define ISB_OBJ_EXECTIME 10

#define ISB_GRP_MAX 32
#define ISB_GRP_EEADDR_START 0x0148



#include <trunk/core/isb_fw_app.c>
