adlerweb/iSysBus/software/firmware/isysbus_lib/current/mod/mod_systimer.h

#ifndef MOD_SYSTIMER_H_
#define MOD_SYSTIMER_H_

/*! @file  mod_systimer.h
 * @brief System Timer. Erzeugt jede ms ein Interrupt. Stellt einen Tick-counter Bereit.
 * Es wird Timer 2 Verwendet, prescalor 64, match compare 125 (bei 8Mhz) 
 * @author Cosinus
 * @date   20.08.2006  
*/

/*@todo System Timer porgrammieren. */
/*@todo Wie werden Funktionen aus anderen modulen oder des hautprogramms aufgerufen, ohne dass die moduldatei verändert werden muss?*/



#endif /*MOD_SYSTIMER_H_*/
