adlerweb/iSysBus/software/firmware/isysbus_lib/current/mod/mod_twi.h

#ifndef MOD_TWI_H_
#define MOD_TWI_H_
/*! @file  mod_twi.h
 * @brief Hier kommen die anstuerung und initialisierung des twi-busses rein 
 * @author Cosinus
 * @date   20.08.2006  
*/

#endif /*MOD_TWI_H_*/
