adlerweb/iSysBus/software/isbd/branches/kasi-isbdng/src/Parameters.h

/**
==================================================

	parameters.h
	
Version: $Rev$
Last Modification: $Id$

Module: 
Created: 01.07.2007
Author: ig

Copyright 2007 by iSysBus

==================================================
*/
#ifndef PARAMETERS_H_
#define PARAMETERS_H_

void define_parameters(int argc, char *argv[]);
void parse_parameters(void);
void print_version(void);

#endif /*PARAMETERS_H_*/
