adlerweb/iSysBus/software/isbd/branches/kasi-isbdng/src/const.h

/**
==================================================

	const.h
	
Version: $Rev$
Last Modification: $Id$

Module: 
Created: 01.06.2007
Author: ig

Copyright 2007 by iSysBus

==================================================
*/
#ifndef CONST_H_
#define CONST_H_

#define _PROGRAM_NAME isb_daemon
#define _PROGRAM_COPYRIGHT Copyright 2007 by iSysBus.org

#endif /*CONST_H_*/
