adlerweb/iSysBus/software/isbd/branches/kasi-isbdng/src/linux_server.h

/**
==================================================

	linux_server.h
	
Version: $Rev$
Last Modification: $Id$

Module: 
Created: 01.07.2007
Author: ig

Copyright 2007 by iSysBus

==================================================
*/
#ifndef UNIX_SERVER_H_
#define UNIX_SERVER_H_
#include <stdio.h>
#include <stdlib.h>
#include <string.h>
#include <errno.h>
#include <sys/types.h>
#include <sys/socket.h>
#include <netinet/in.h>
#include <netdb.h>
#include <arpa/inet.h>
#include <unistd.h>

// Create abstract socket type
#define socket_t int
#define SOCKET_ERROR -1
//#define socklen_t int

void error_exit(const char *error_message);
int create_socket( int af, int type, int protocol );
void bind_socket(socket_t *sock, unsigned long adress, unsigned short port);
void listen_socket( socket_t *sock );
void accept_socket( socket_t *new_socket, socket_t *socket );
void connect_socket(socket_t *sock, char *serv_addr, unsigned short port);
int TCP_send( socket_t *sock, char *data, size_t size);
int TCP_recv( socket_t *sock, char *data, size_t size);
void UDP_send ( socket_t *sock, char *data, size_t size, char *addr, unsigned short port);
void UDP_recv( socket_t *sock, char *data, size_t size);
void close_socket( socket_t *sock );
void cleanup(void);

#endif /*UNIX_SERVER_H_*/
